COSMIIC-Inc/Implantables-NetworkCable/Mechanical Design CAD Files/Solidworks Native Files/NNP-DWG-145-002-000 Network Cable.SLDASM

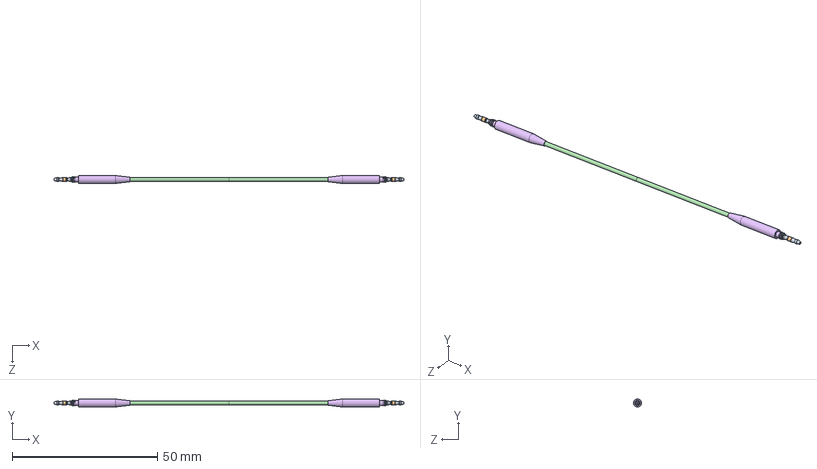
[picture p2: CAD file, 2024-06-21]
Mechanical Design CAD Files/Solidworks Native Files/NNP-DWG-145-002-000 Network Cable.SLDASM
120.3 x 2.79 x 2.79 mm
NNP-DWG-140-004-000 Interconnect, Front-Rear Insulator x 2
NNP-DWG-140-002-001 Interconnect, Rear Contact, SS x 2
NNP-DWG-140-007-001 Interconnect, Front Weld Sleeve, SS x 2
NNP-DWG-140-008-001 Interconnect, Crimp Weld Reducer, SS x 2
NNP-DWG-140-009-000 Interconnect, Silicone Over Mold x 2
NNP-DWG-140-010-000 Filar, DFT, Blue-Clear x 2
NNP-DWG-140-012-000 Cable, Insulating Silicone Tubing x 2
NNP-DWG-140-003-001 Interconnect, NNP Center Conductor, SS x 2
NNP-DWG-140-005-001 Interconnect, Strain Relief, SS x 2
NNP-DWG-140-001-001 Interconnect, Front Contact, SS x 2
