COSMIIC-Inc/Implantables-NetworkCable/Mechanical Design CAD Files/Solidworks Native Files/NNP-DWG-145-006-000 SA, Network-Interconnect.SLDASM

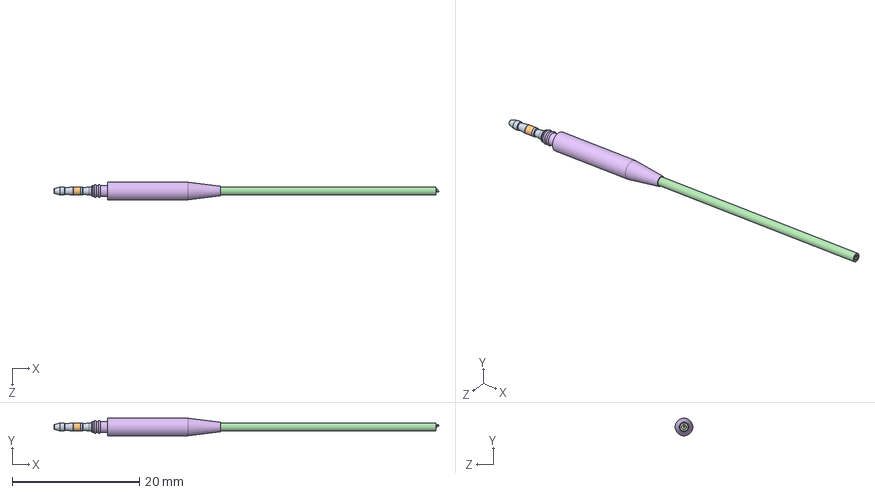
[picture p3: CAD file, 2024-06-21]
Mechanical Design CAD Files/Solidworks Native Files/NNP-DWG-145-006-000 SA, Network-Interconnect.SLDASM
60.6 x 2.78 x 2.78 mm
NNP-DWG-140-004-000 Interconnect, Front-Rear Insulator
NNP-DWG-140-002-001 Interconnect, Rear Contact, SS
NNP-DWG-140-007-001 Interconnect, Front Weld Sleeve, SS
NNP-DWG-140-008-001 Interconnect, Crimp Weld Reducer, SS
NNP-DWG-140-009-000 Interconnect, Silicone Over Mold
NNP-DWG-140-010-000 Filar, DFT, Blue-Clear
NNP-DWG-140-012-000 Cable, Insulating Silicone Tubing
NNP-DWG-140-003-001 Interconnect, NNP Center Conductor, SS
NNP-DWG-140-005-001 Interconnect, Strain Relief, SS
NNP-DWG-140-001-001 Interconnect, Front Contact, SS
