COSMIIC-Inc/Implantables-NetworkCable/Mechanical Design CAD Files/Solidworks Native Files/NNP-DWG-140-004-000 Interconnect, Front-Rear Insulator.SLDPRT

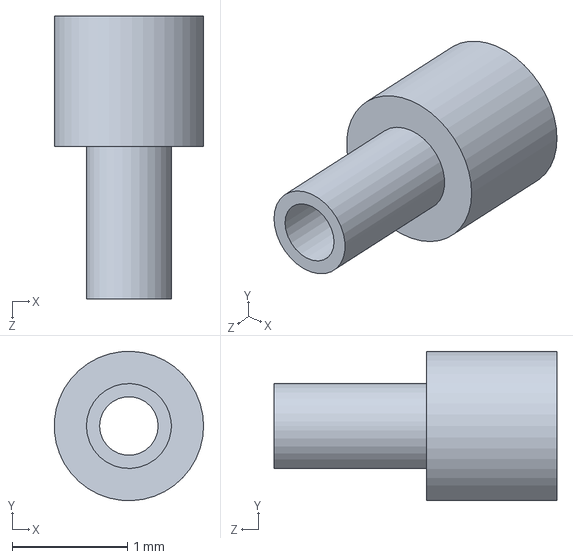
[picture p4: CAD file, 2024-06-26]
Mechanical Design CAD Files/Solidworks Native Files/NNP-DWG-140-004-000 Interconnect, Front-Rear Insulator.SLDPRT
1.29 x 1.29 x 2.45 mm
