COSMIIC-Inc/Implantables-NetworkCable/Mechanical Design CAD Files/STEP Files/NNP-DWG-140-005-000 Interconnect, Strain Relief.STEP

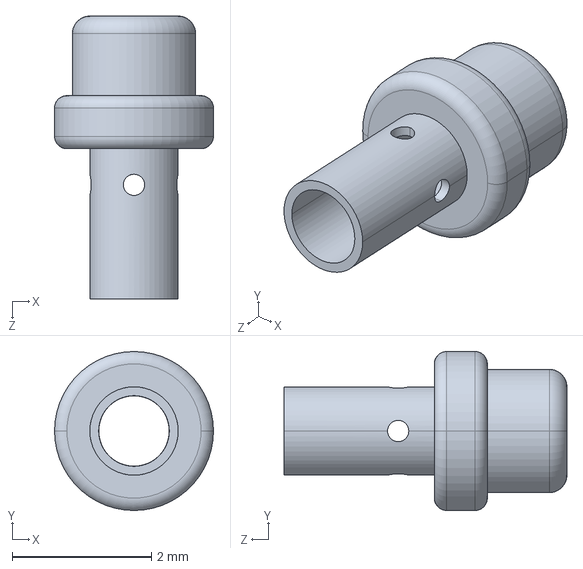
[picture p5: CAD file, 2024-06-21]
Mechanical Design CAD Files/STEP Files/NNP-DWG-140-005-000 Interconnect, Strain Relief.STEP
2.29 x 2.29 x 4.06 mm
