COSMIIC-Inc/Implantables-NetworkCable/Mechanical Design CAD Files/STEP Files/NNP-DWG-140-001-000 Interconnect, Front Contact.STEP

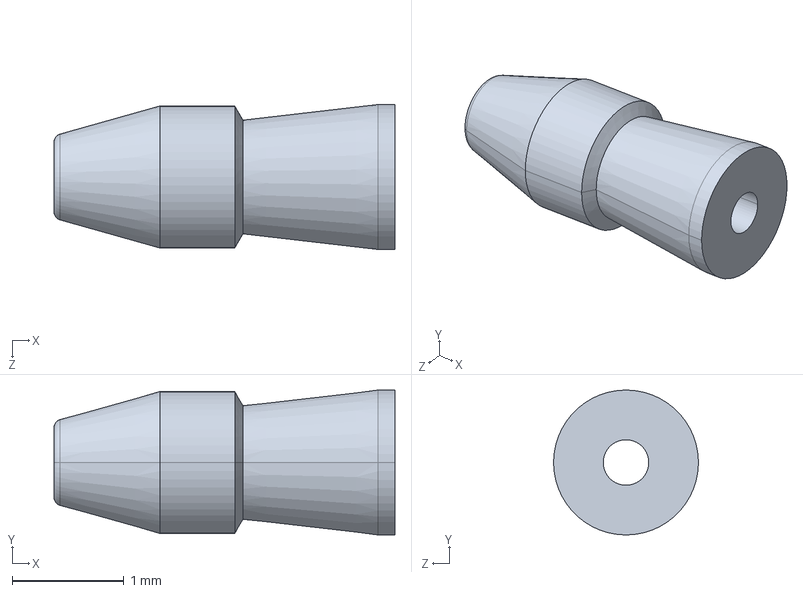
[picture p6: CAD file, 2024-06-21]
Mechanical Design CAD Files/STEP Files/NNP-DWG-140-001-000 Interconnect, Front Contact.STEP
3.05 x 1.30 x 1.30 mm
