COSMIIC-Inc/Implantables-NetworkCable/Mechanical Design CAD Files/STEP Files/NNP-DWG-140-008-000 Interconnect, Crimp Weld Reducer.STEP

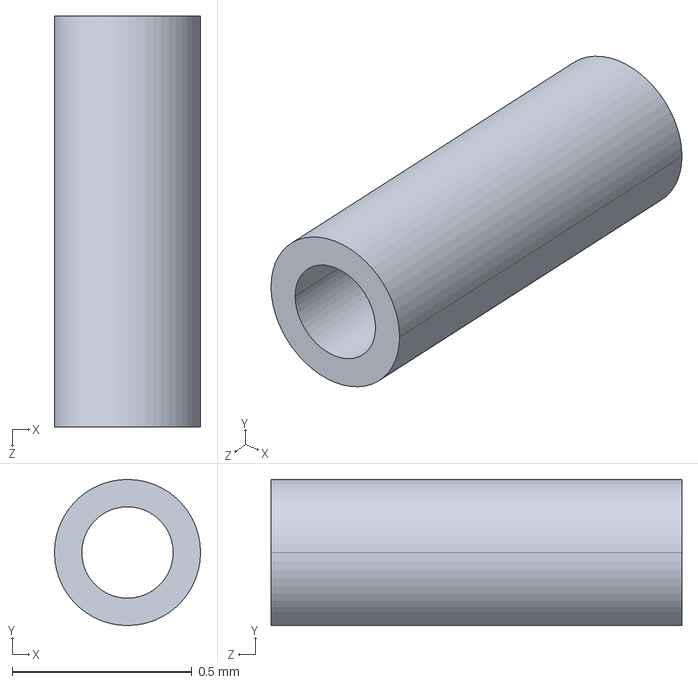
[picture p8: CAD file, 2024-06-21]
Mechanical Design CAD Files/STEP Files/NNP-DWG-140-008-000 Interconnect, Crimp Weld Reducer.STEP
0.406 x 0.406 x 1.14 mm
