COSMIIC-Inc/Implantables-NetworkCable/Mechanical Design CAD Files/STEP Files/NNP-DWG-140-002-000 Interconnect, Rear Contact.STEP

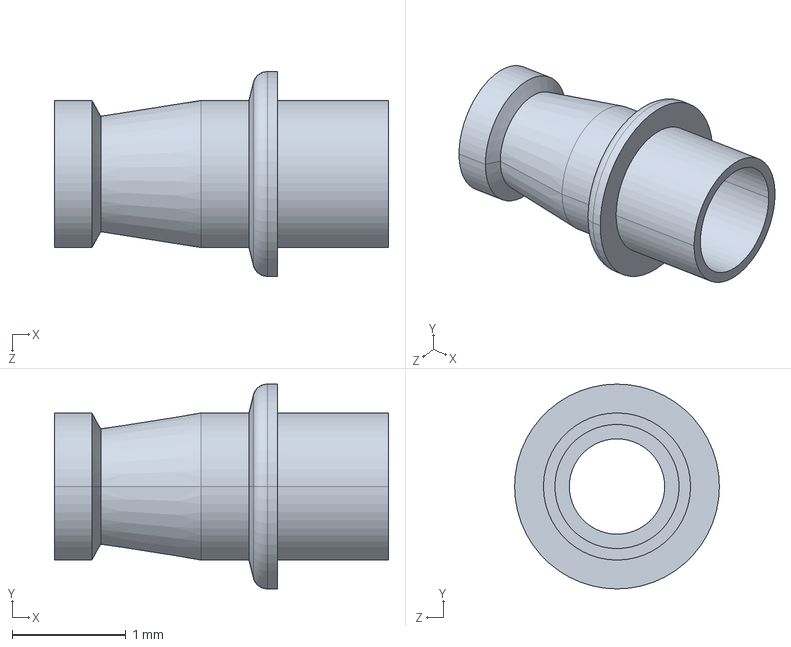
[picture p9: CAD file, 2024-06-21]
Mechanical Design CAD Files/STEP Files/NNP-DWG-140-002-000 Interconnect, Rear Contact.STEP
2.94 x 1.80 x 1.80 mm
