COSMIIC-Inc/Implantables-NetworkCable/Mechanical Design CAD Files/STEP Files/NNP-DWG-140-007-000 Interconnect, Front Weld Sleeve.STEP

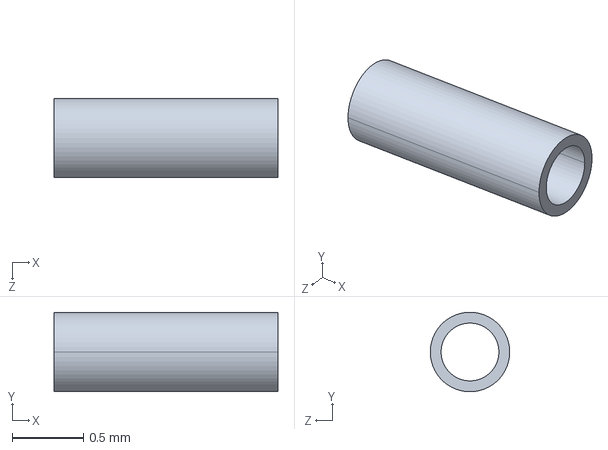
[picture p10: CAD file, 2024-06-21]
Mechanical Design CAD Files/STEP Files/NNP-DWG-140-007-000 Interconnect, Front Weld Sleeve.STEP
1.57 x 0.559 x 0.559 mm
