COSMIIC-Inc/Implantables-NetworkCable/Mechanical Design CAD Files/Solidworks Native Files/NNP-DWG-140-010-000 Filar, DFT, Blue-Clear.SLDPRT

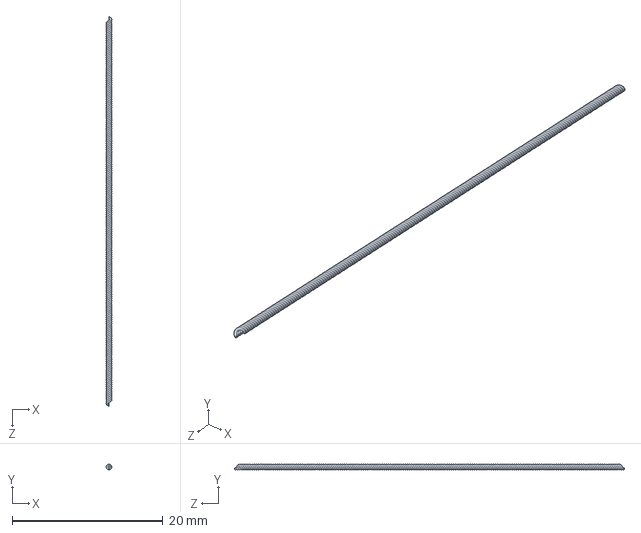
[picture p11: CAD file, 2024-06-21]
Mechanical Design CAD Files/Solidworks Native Files/NNP-DWG-140-010-000 Filar, DFT, Blue-Clear.SLDPRT
0.754 x 0.754 x 51.8 mm
