COSMIIC-Inc/Implantables-NetworkCable/Mechanical Design CAD Files/Solidworks Native Files/NNP-DWG-140-009-000 Interconnect, Silicone Over Mold.SLDPRT

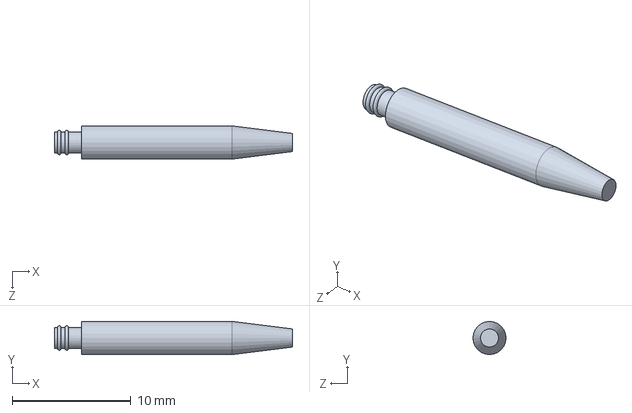
[picture p12: CAD file, 2024-06-21]
Mechanical Design CAD Files/Solidworks Native Files/NNP-DWG-140-009-000 Interconnect, Silicone Over Mold.SLDPRT
20.1 x 2.79 x 2.79 mm
