COSMIIC-Inc/Implantables-NetworkCable/Mechanical Design CAD Files/STEP Files/NNP-DWG-140-012-000 Cable, Insulating Silicone Tubing.STEP

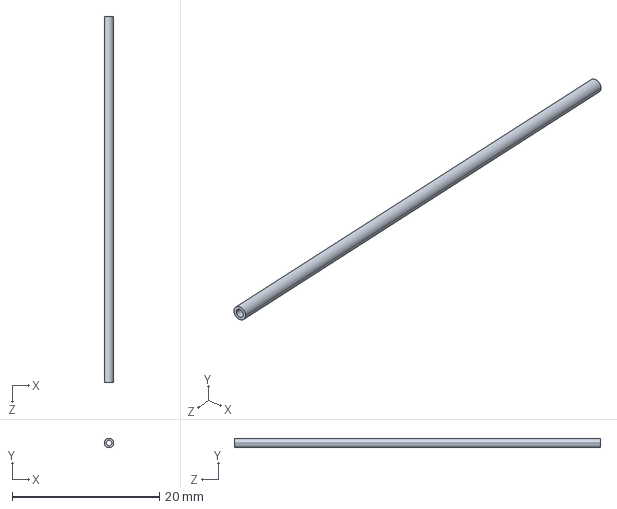
[picture p13: CAD file, 2024-06-21]
Mechanical Design CAD Files/STEP Files/NNP-DWG-140-012-000 Cable, Insulating Silicone Tubing.STEP
1.27 x 1.27 x 49.8 mm
