COSMIIC-Inc/Implantables-NetworkCable/(list of files, cad)

Other CAD files:
Mechanical Design CAD Files/Solidworks Native Files/NNP-DWG-140-008-001 Interconnect, Crimp Weld Reducer, SS.SLDPRT
Mechanical Design CAD Files/Solidworks Native Files/NNP-DWG-140-005-002 Interconnect, Strain Relief, Pt-Ir.SLDPRT
Mechanical Design CAD Files/STEP Files/NNP-DWG-145-001-000 Interconnect.STEP
Mechanical Design CAD Files/Solidworks Native Files/NNP-DWG-140-001-001 Interconnect, Front Contact, SS.SLDPRT
Mechanical Design CAD Files/STEP Files/NNP-DWG-140-004-000 Interconnect, Front-Rear Insulator.STEP
Mechanical Design CAD Files/Solidworks Native Files/NNP-DWG-140-008-002 Interconnect, Crimp Weld Reducer, Pt-Ir.SLDPRT
Mechanical Design CAD Files/STEP Files/NNP-DWG-140-003-000 Interconnect, NNP Center Conductor.STEP
Mechanical Design CAD Files/Solidworks Native Files/NNP-DWG-140-007-002 Interconnect, Front Weld Sleeve, Pt-Ir.SLDPRT
Mechanical Design CAD Files/STEP Files/NNP-DWG-140-009-000 Interconnect, Silicone Over Mold.STEP
Mechanical Design CAD Files/Solidworks Native Files/NNP-DWG-140-002-001 Interconnect, Rear Contact, SS.SLDPRT
Mechanical Design CAD Files/Solidworks Native Files/NNP-DWG-140-007-001 Interconnect, Front Weld Sleeve, SS.SLDPRT
Mechanical Design CAD Files/Solidworks Native Files/NNP-DWG-140-002-002 Interconnect, Rear Contact, Pt-Ir.SLDPRT
Mechanical Design CAD Files/Solidworks Native Files/NNP-DWG-140-012-000 Cable, Insulating Silicone Tubing.SLDPRT
Mechanical Design CAD Files/Solidworks Native Files/NNP-DWG-140-001-002 Interconnect, Front Contact, Pt-Ir.SLDPRT
Mechanical Design CAD Files/Solidworks Native Files/NNP-DWG-140-005-001 Interconnect, Strain Relief, SS.SLDPRT
Mechanical Design CAD Files/Solidworks Native Files/NNP-DWG-140-003-002 Interconnect, NNP Center Conductor, Pt-Ir.SLDPRT
Mechanical Design CAD Files/STEP Files/NNP-DWG-140-006-000 Interconnect, Washer.STEP
Mechanical Design CAD Files/Solidworks Native Files/NNP-DWG-140-001-001 Interconnect, Front Contact, SS.SLDDRW
Mechanical Design CAD Files/Solidworks Native Files/NNP-DWG-140-001-002 Interconnect, Front Contact, Pt-Ir.SLDDRW
Mechanical Design CAD Files/Solidworks Native Files/NNP-DWG-140-002-001 Interconnect, Rear Contact, SS.SLDDRW
Mechanical Design CAD Files/Solidworks Native Files/NNP-DWG-140-002-002 Interconnect, Rear Contact, Pt-Ir.SLDDRW
Mechanical Design CAD Files/Solidworks Native Files/NNP-DWG-140-003-001 Interconnect, NNP Center Conductor, SS.SLDDRW
Mechanical Design CAD Files/Solidworks Native Files/NNP-DWG-140-003-002 Interconnect, NNP Center Conductor, Pt-Ir.SLDDRW
Mechanical Design CAD Files/Solidworks Native Files/NNP-DWG-140-004-000 Interconnect, Front-Rear Insulator.SLDDRW
Mechanical Design CAD Files/Solidworks Native Files/NNP-DWG-140-005-001 Interconnect, Strain Relief, SS.SLDDRW
Mechanical Design CAD Files/Solidworks Native Files/NNP-DWG-140-005-002 Interconnect, Strain Relief, Pt-Ir.SLDDRW
Mechanical Design CAD Files/Solidworks Native Files/NNP-DWG-140-006-000 Interconnect, Washer.SLDDRW
Mechanical Design CAD Files/Solidworks Native Files/NNP-DWG-140-006-000 Interconnect, Washer.SLDPRT
Mechanical Design CAD Files/Solidworks Native Files/NNP-DWG-140-007-001 Interconnect, Front Weld Sleeve, SS.SLDDRW
Mechanical Design CAD Files/Solidworks Native Files/NNP-DWG-140-007-002 Interconnect, Front Weld Sleeve, Pt-Ir.SLDDRW
Mechanical Design CAD Files/Solidworks Native Files/NNP-DWG-140-008-001 Interconnect, Crimp Weld Reducer, SS.SLDDRW
Mechanical Design CAD Files/Solidworks Native Files/NNP-DWG-140-008-002 Interconnect, Crimp Weld Reducer, Pt-Ir.SLDDRW
Mechanical Design CAD Files/Solidworks Native Files/NNP-DWG-140-009-000 Interconnect, Silicone Over Mold.SLDDRW
Mechanical Design CAD Files/Solidworks Native Files/NNP-DWG-140-010-000 Filar, DFT, Blue-Clear.SLDDRW
Mechanical Design CAD Files/Solidworks Native Files/NNP-DWG-140-012-000 Cable, Insulating Silicone Tubing.SLDDRW
Mechanical Design CAD Files/Solidworks Native Files/NNP-DWG-145-001-001 Interconnect, SS.SLDDRW
Mechanical Design CAD Files/Solidworks Native Files/NNP-DWG-145-001-002 Interconnect, Pt-Ir.SLDDRW
Mechanical Design CAD Files/Solidworks Native Files/NNP-DWG-145-002-000 Network Cable.SLDDRW
Mechanical Design CAD Files/Solidworks Native Files/NNP-DWG-145-006-001 SA, Network-Interconnect, SS.SLDDRW
Mechanical Design CAD Files/Solidworks Native Files/NNP-DWG-145-006-002 SA, Network-Interconnect, Pt-Ir.SLDDRW
