COSMIIC-Inc/Implantables-NetworkCable/Mechanical Design CAD Files/Drawing PDFs/Exploded Network Cable.pdf

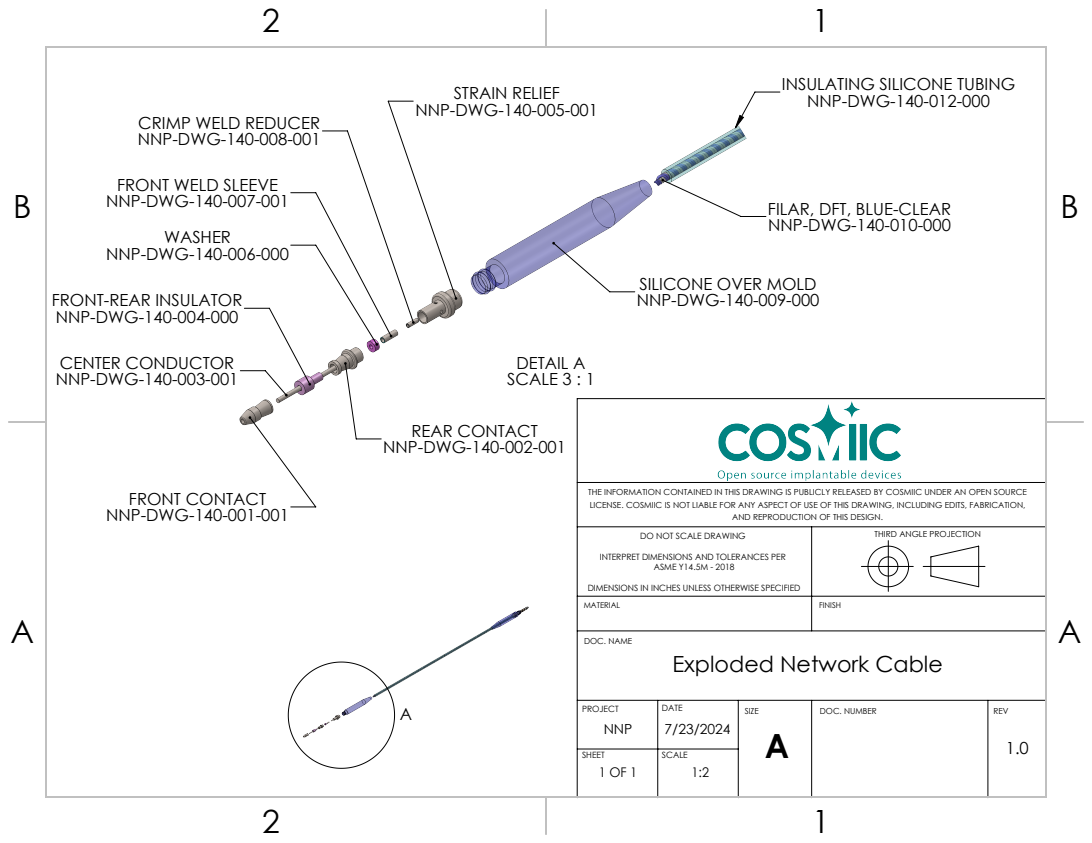
[picture p14: page 1]
DETAIL A SCALE 3 : 1; FRONT CONTACT; CENTER CONDUCTOR; REAR CONTACT; STRAIN RELIEF; ASME Y14.5M - 2018; DOC. NAME; DOC. NUMBER; REV

INSULATING SILICONE TUBING
NNP-DWG-140-012-000

CRIMP WELD REDUCER
NNP-DWG-140-008-001

FRONT WELD SLEEVE
NNP-DWG-140-007-001
WASHER
NNP-DWG-140-006-000

FILAR, DFT, BLUE-CLEAR
NNP-DWG-140-010-000

SILICONE OVER MOLD
NNP-DWG-140-009-000

FRONT-REAR INSULATOR
NNP-DWG-140-004-000

THE INFORMATION CONTAINED IN THIS DRAWING IS PUBLICLY RELEASED BY COSMIIC UNDER AN OPEN SOURCE
LICENSE. COSMIIC IS NOT LIABLE FOR ANY ASPECT OF USE OF THIS DRAWING, INCLUDING EDITS, FABRICATION,

AND REPRODUCTION OF THIS DESIGN.

DO NOT SCALE DRAWING

THIRD ANGLE PROJECTION

INTERPRET DIMENSIONS AND TOLERANCES PER

DIMENSIONS IN INCHES UNLESS OTHERWISE SPECIFIED
Exploded Network Cable
