COSMIIC-Inc/Implantables-NetworkCable/Mechanical Design CAD Files/Drawing PDFs/NNP-DWG-140-010-000 Filar, DFT, Blue-Clear.pdf

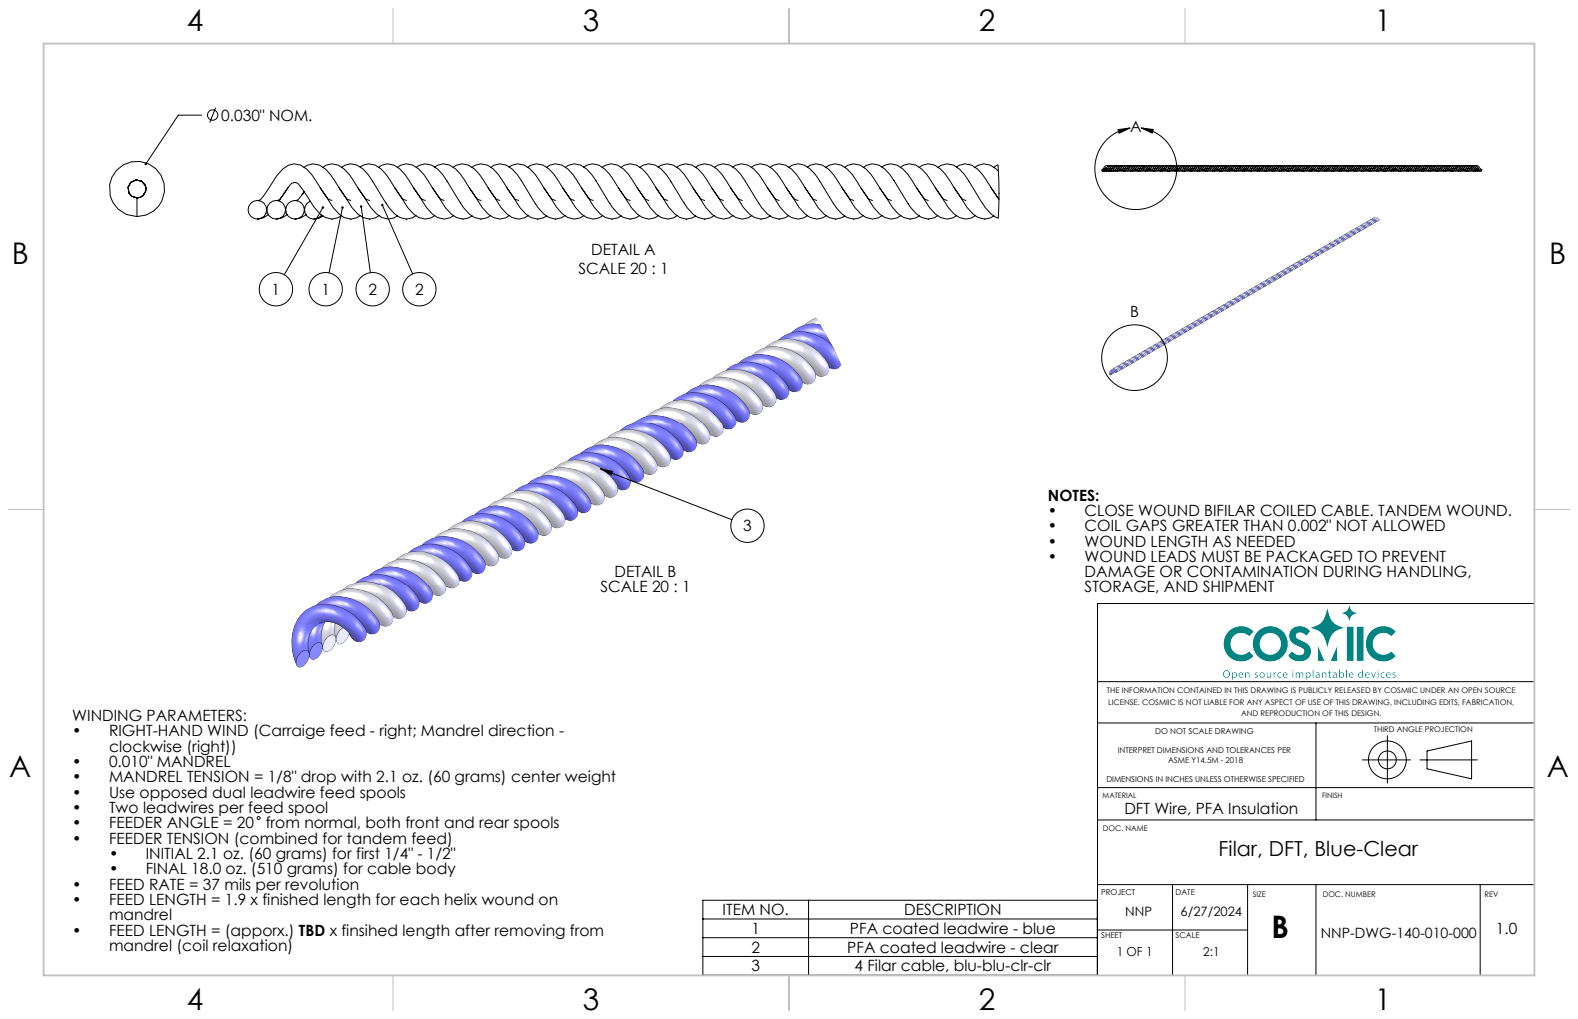
[picture p15: page 1]
DETAIL A SCALE 20 : 1; DETAIL B SCALE 20 : 1; 0.030" NOM.; clockwise (right)) •; 0.010" MANDREL •; MANDREL TENSION = 1/8" drop with 2.1 oz. (60 grams) center weight •; Use opposed dual leadwire feed spools •; Two leadwires per feed spool •; FEEDER ANGLE = 20 from normal, both front and rear spools •; FEEDER TENSION (combined for tandem feed); INITIAL 2.1 oz. (60 grams) for first 1/4" - 1/2" •; FINAL 18.0 oz. (510 grams) for cable body •; FEED RATE = 37 mils per revolution •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

DAMAGE OR CONTAMINATION DURING HANDLING,
STORAGE, AND SHIPMENT

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

WINDING PARAMETERS:
• RIGHT-HAND WIND (Carraige feed - right; Mandrel direction -

AND REPRODUCTION OF THIS DESIGN.

DO NOT SCALE DRAWING

THIRD ANGLE PROJECTION

INTERPRET DIMENSIONS AND TOLERANCES PER

DIMENSIONS IN INCHES UNLESS OTHERWISE SPECIFIED
DFT Wire, PFA Insulation

Filar, DFT, Blue-Clear
NNP-DWG-140-010-000

ITEM NO. | DESCRIPTION
1 | PFA coated leadwire - blue
2 | PFA coated leadwire - clear
3 | 4 Filar cable, blu-blu-clr-clr

mandrel (coil relaxation)
