COSMIIC-Inc/Implantables-NetworkCable/Mechanical Design CAD Files/Drawing PDFs/NNP-DWG-145-001-001 Interconnect, SS.pdf

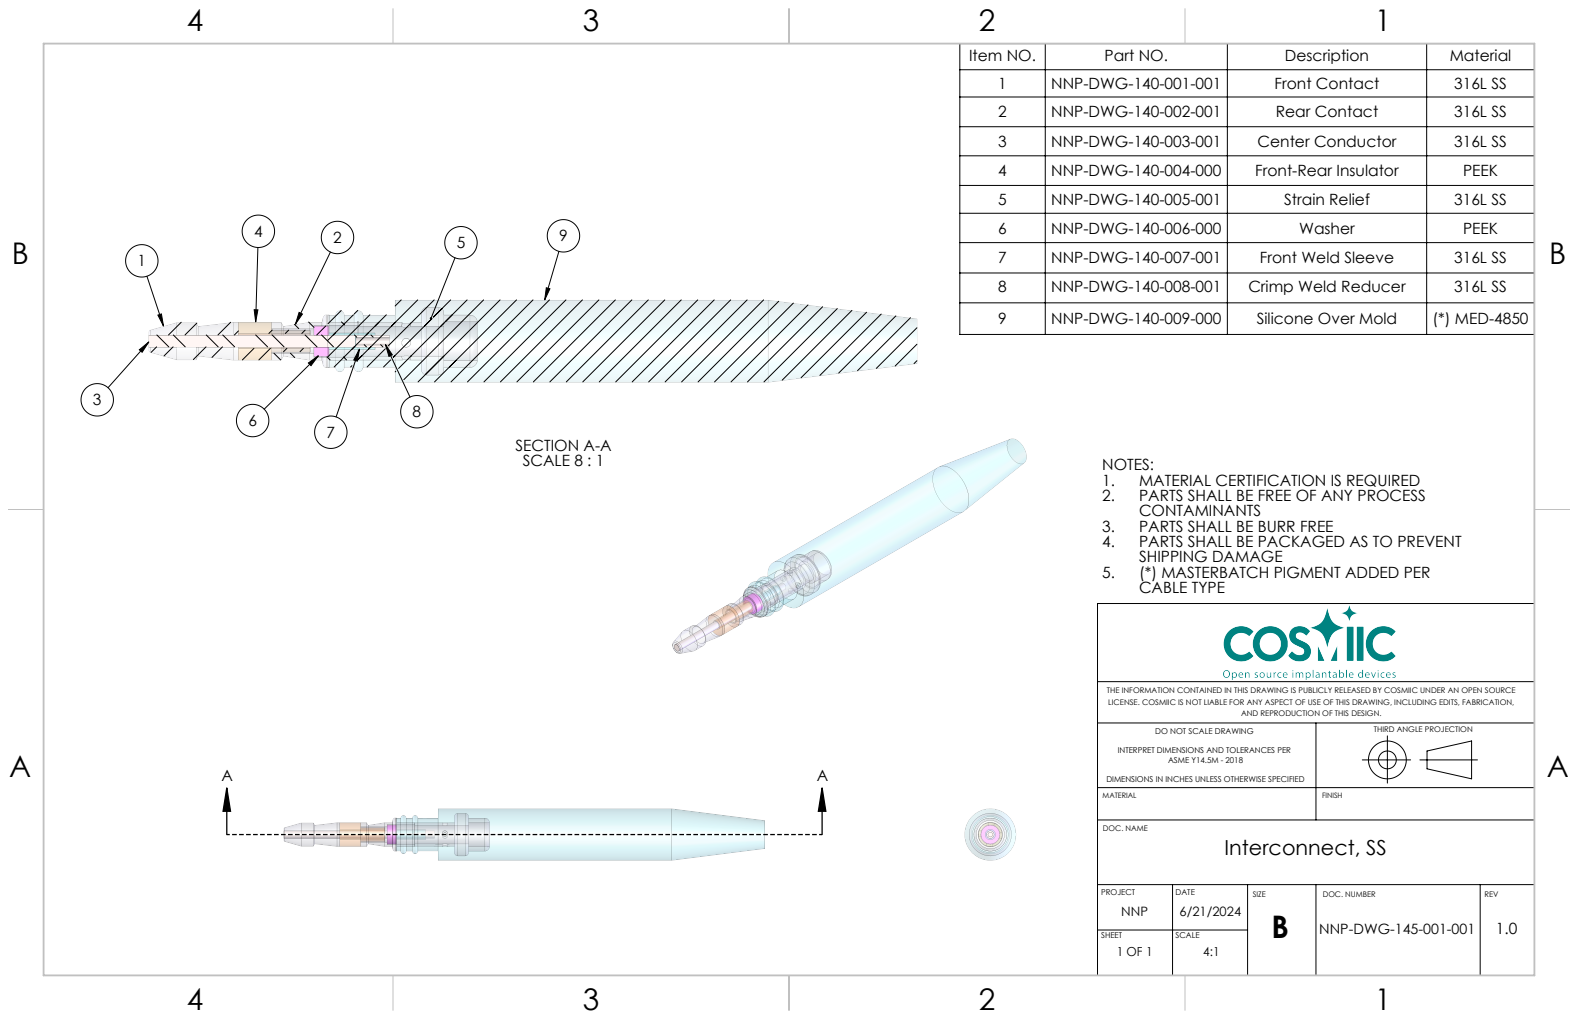
[picture p16: page 1]
SECTION A-A; SCALE 8 : 1 9; Item NO.; Part NO.; Description; Material 1; NNP-DWG-140-001-001; Front Contact; NNP-DWG-140-002-001; Rear Contact; NNP-DWG-140-003-001; Center Conductor; NNP-DWG-140-004-000; Front-Rear Insulator; PEEK 5; NNP-DWG-140-005-001; Strain Relief; NNP-DWG-140-006-000; Washer; PEEK 7; NNP-DWG-140-007-001; Front Weld Sleeve; NNP-DWG-140-008-001; Crimp Weld Reducer; NNP-DWG-140-009-000; Silicone Over Mold; (*) MED-4850; DOC. NUMBER; REV; DOC. NAME; ASME Y14.5M - 2018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

NOTES:
1. MATERIAL CERTIFICATION IS REQUIRED
2. PARTS SHALL BE FREE OF ANY PROCESS
CONTAMINANTS
3. PARTS SHALL BE BURR FREE
4. PARTS SHALL BE PACKAGED AS TO PREVENT
SHIPPING DAMAGE
5. (*) MASTERBATCH PIGMENT ADDED PER
CABLE TYPE

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

AND REPRODUCTION OF THIS DESIGN.

DO NOT SCALE DRAWING

THIRD ANGLE PROJECTION

INTERPRET DIMENSIONS AND TOLERANCES PER

DIMENSIONS IN INCHES UNLESS OTHERWISE SPECIFIED
