COSMIIC-Inc/Implantables-NetworkCable/Mechanical Design CAD Files/Drawing PDFs/NNP-DWG-140-009-000 Interconnect, Silicone Over Mold.pdf

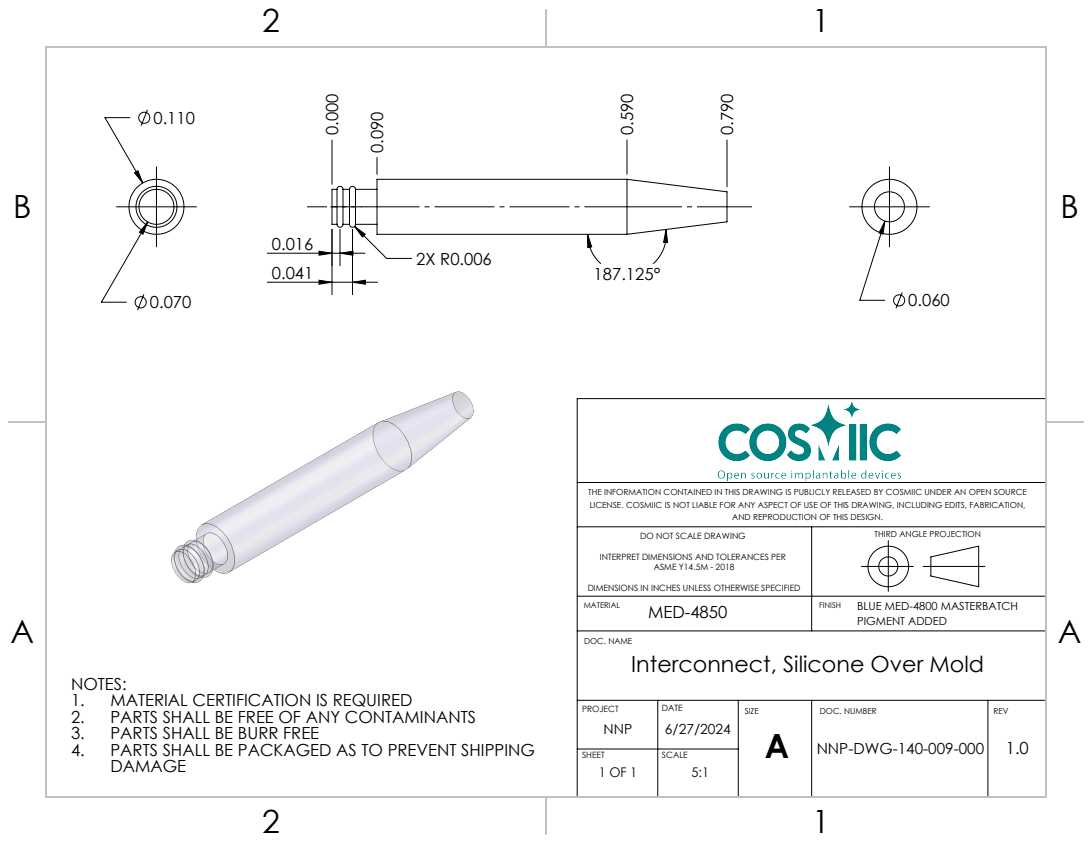
[picture p17: page 1]
BLUE MED-4800 MASTERBATCH MED-4850; PIGMENT ADDED; ASME Y14.5M - 2018; DOC. NAME; DOC. NUMBER; REV

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

AND REPRODUCTION OF THIS DESIGN.

DO NOT SCALE DRAWING

THIRD ANGLE PROJECTION

INTERPRET DIMENSIONS AND TOLERANCES PER

DIMENSIONS IN INCHES UNLESS OTHERWISE SPECIFIED
Interconnect, Silicone Over Mold
NNP-DWG-140-009-000 1.0

NOTES:
1. MATERIAL CERTIFICATION IS REQUIRED
2. PARTS SHALL BE FREE OF ANY CONTAMINANTS
3. PARTS SHALL BE BURR FREE
4. PARTS SHALL BE PACKAGED AS TO PREVENT SHIPPING
DAMAGE
