COSMIIC-Inc/Implantables-NetworkCable/Mechanical Design CAD Files/Drawing PDFs/NNP-DWG-145-006-001 SA, Network-Interconnect, SS.pdf

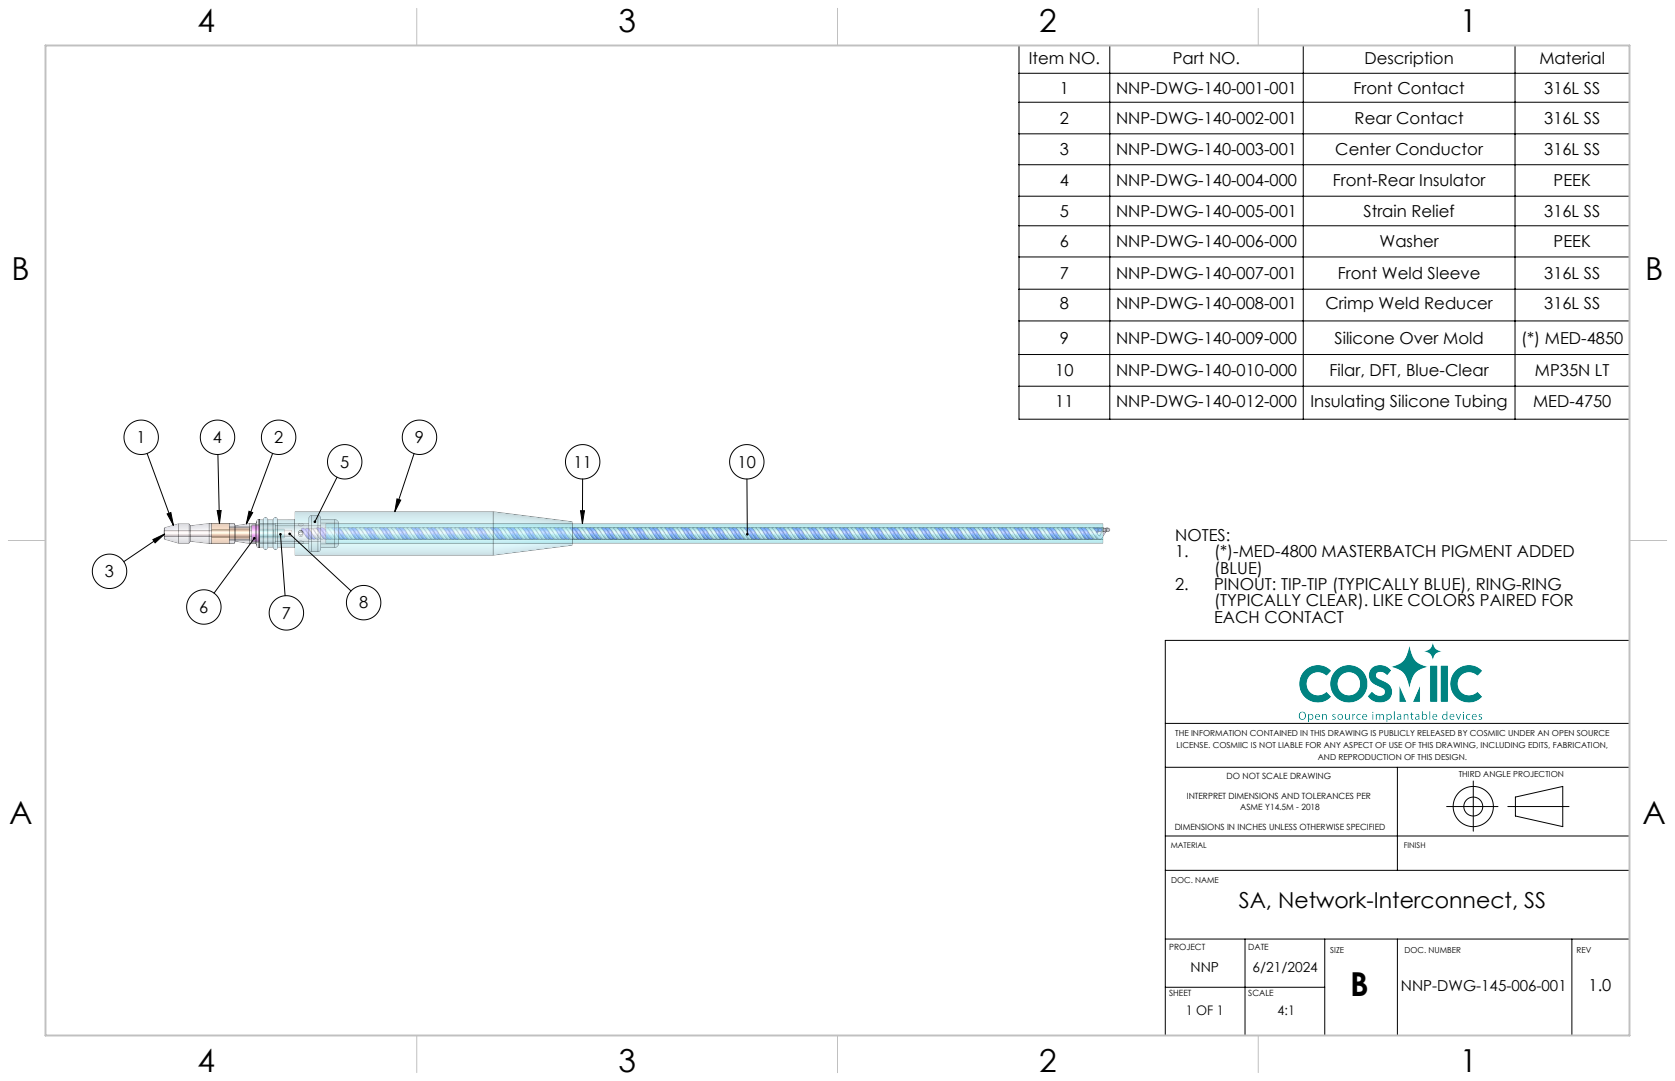
[picture p19: page 1]
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

10 | NNP-DWG-140-010-000 | Filar, DFT, Blue-Clear | MP35N LT
11 | NNP-DWG-140-012-000 | Insulating Silicone Tubing | MED-4750

NOTES:
1. (*)-MED-4800 MASTERBATCH PIGMENT ADDED
(BLUE)
2. PINOUT: TIP-TIP (TYPICALLY BLUE), RING-RING
(TYPICALLY CLEAR). LIKE COLORS PAIRED FOR
EACH CONTACT

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

AND REPRODUCTION OF THIS DESIGN.

DO NOT SCALE DRAWING

THIRD ANGLE PROJECTION

INTERPRET DIMENSIONS AND TOLERANCES PER

DIMENSIONS IN INCHES UNLESS OTHERWISE SPECIFIED
SA, Network-Interconnect, SS
NNP-DWG-145-006-001
