COSMIIC-Inc/Implantables-NetworkCable/Mechanical Design CAD Files/Drawing PDFs/NNP-DWG-140-007-001 Interconnect, Front Weld Sleeve, SS.pdf

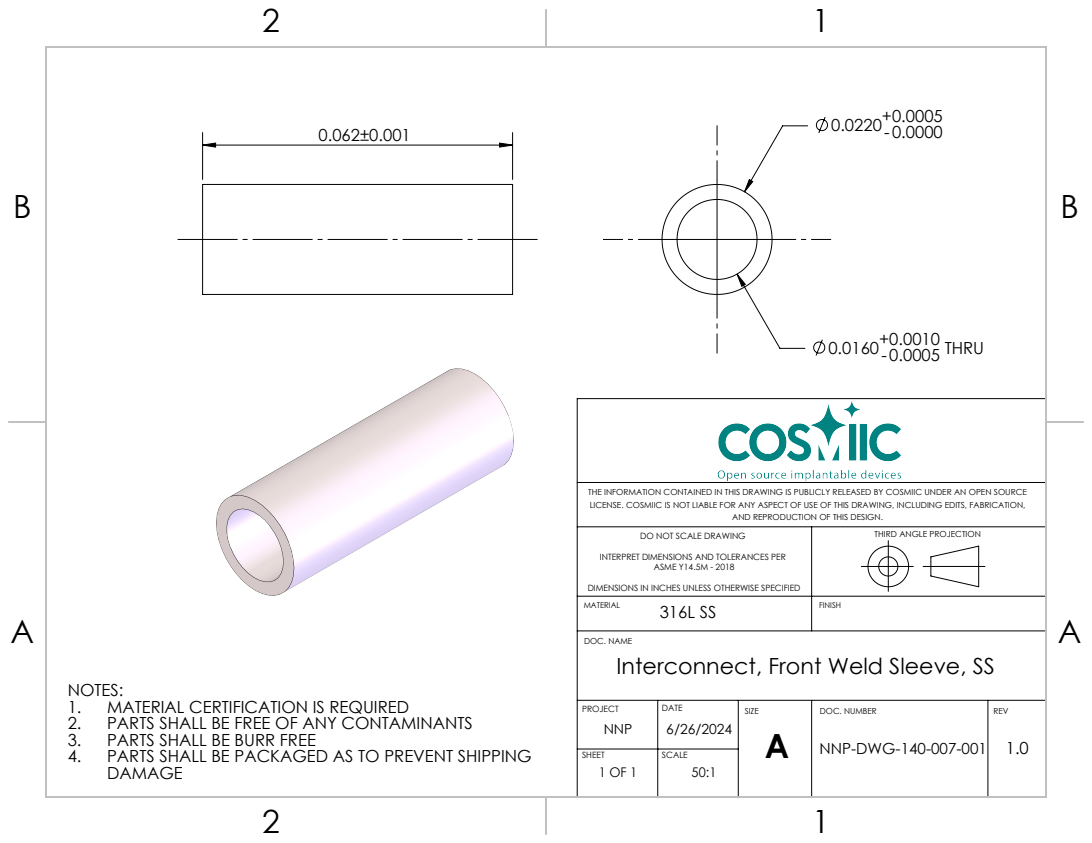
[picture p21: page 1]
0.0005 THRU; NNP-DWG-140-007-001 1.0; DOC. NAME; DOC. NUMBER; REV

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

AND REPRODUCTION OF THIS DESIGN.

DO NOT SCALE DRAWING

THIRD ANGLE PROJECTION

INTERPRET DIMENSIONS AND TOLERANCES PER

ASME Y14.5M - 2018
Interconnect, Front Weld Sleeve, SS

DIMENSIONS IN INCHES UNLESS OTHERWISE SPECIFIED

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
