COSMIIC-Inc/Implantables-NetworkCable/(commit log)

2024-06-24 Update license agreement on prints
    [NNP-DWG-145-001-001 Interconnect, SS.SLDDRW, NNP-DWG-145-001-002 Interconnect, Pt-Ir.SLDDRW, NNP-DWG-145-002-000 Network Cable.SLDDRW, NNP-DWG-145-006-001 SA, Network-Interconnect, SS.SLDDRW, NNP-DWG-145-006-002 SA, Network-Interconnect, Pt-Ir.SLDDRW]
2024-06-25 Updated reference doc number within
    Updated the product requirement specification doc number in each protocol PDF only to NNP-REQ-0001 Product Requirement Specification - Network Cable
2024-06-26 Adding more documents
    Starting to implement new interconnect drawings
    [NNP-DWG-140-001-001 Interconnect, Front Contact, SS.SLDDRW, NNP-DWG-140-001-002 Interconnect, Front Contact, Pt-Ir.SLDDRW]
2024-06-26 Adding more documents
    Adding more interconnect drawings with cosmiic branding
    [NNP-DWG-140-002-001 Interconnect, Rear Contact, SS.SLDDRW, NNP-DWG-140-002-002 Interconnect, Rear Contact, Pt-Ir.SLDDRW]
2024-06-26 Adding more documents
    Interconnect drawings branded with cosmiic
    [NNP-DWG-140-003-001 Interconnect, NNP Center Conductor, SS.SLDDRW, NNP-DWG-140-003-001 Interconnect, NNP Center Conductor, SS.SLDPRT, NNP-DWG-140-003-002 Interconnect, NNP Center Conductor, Pt-Ir.SLDDRW, NNP-DWG-140-004-000 Interconnect, Front-Rear Insulator.SLDDRW, NNP-DWG-140-004-000 Interconnect, Front-Rear Insulator.SLDPRT, NNP-DWG-140-005-001 Interconnect, Strain Relief, SS.SLDDRW, NNP-DWG-1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]
2024-06-27 Adding more documents
    Interconnect and network cable components branded with cosmiic. Deleted "alternate rudolf" and "strain coils" because I don't think they are currently in the interconnect
    [NNP-DWG-140-009-000 Interconnect, Silicone Over Mold.SLDDRW, NNP-DWG-140-010-000 Filar, DFT, Blue-Clear.SLDDRW, NNP-DWG-140-012-000 Cable, Insulating Silicone Tubing.SLDDRW, NNP-DWG-140-014-000 Interconnect, Alternate Rudolf.SLDPRT, NNP-DWG-140-014-000 Interconnect, Alternate Rudolf.STEP, NNP-DWG-140-015-000 Interconnect, Strain Coil.SLDPRT, NNP-DWG-140-015-000 Interconnect, Strain Coil.STEP]
2024-07-12 Network Cable Stretch, Crush, Flex Test Reports
2024-07-17 Added masterbatch pigment note
    [NNP-DWG-145-001-000 Interconnect.SLDASM, NNP-DWG-145-001-001 Interconnect, SS.SLDDRW, NNP-DWG-145-001-002 Interconnect, Pt-Ir.SLDDRW]
2024-07-19 Update material note
